Alchemy-Escape-Rooms-Inc/New-Cannons/Design/PCB/Imported-2026-10-09/CannonPCB.kicad_pcb

## KiCad design Design/PCB/Imported-2026-10-09/CannonPCB.kicad_pcb (2026-10-09)

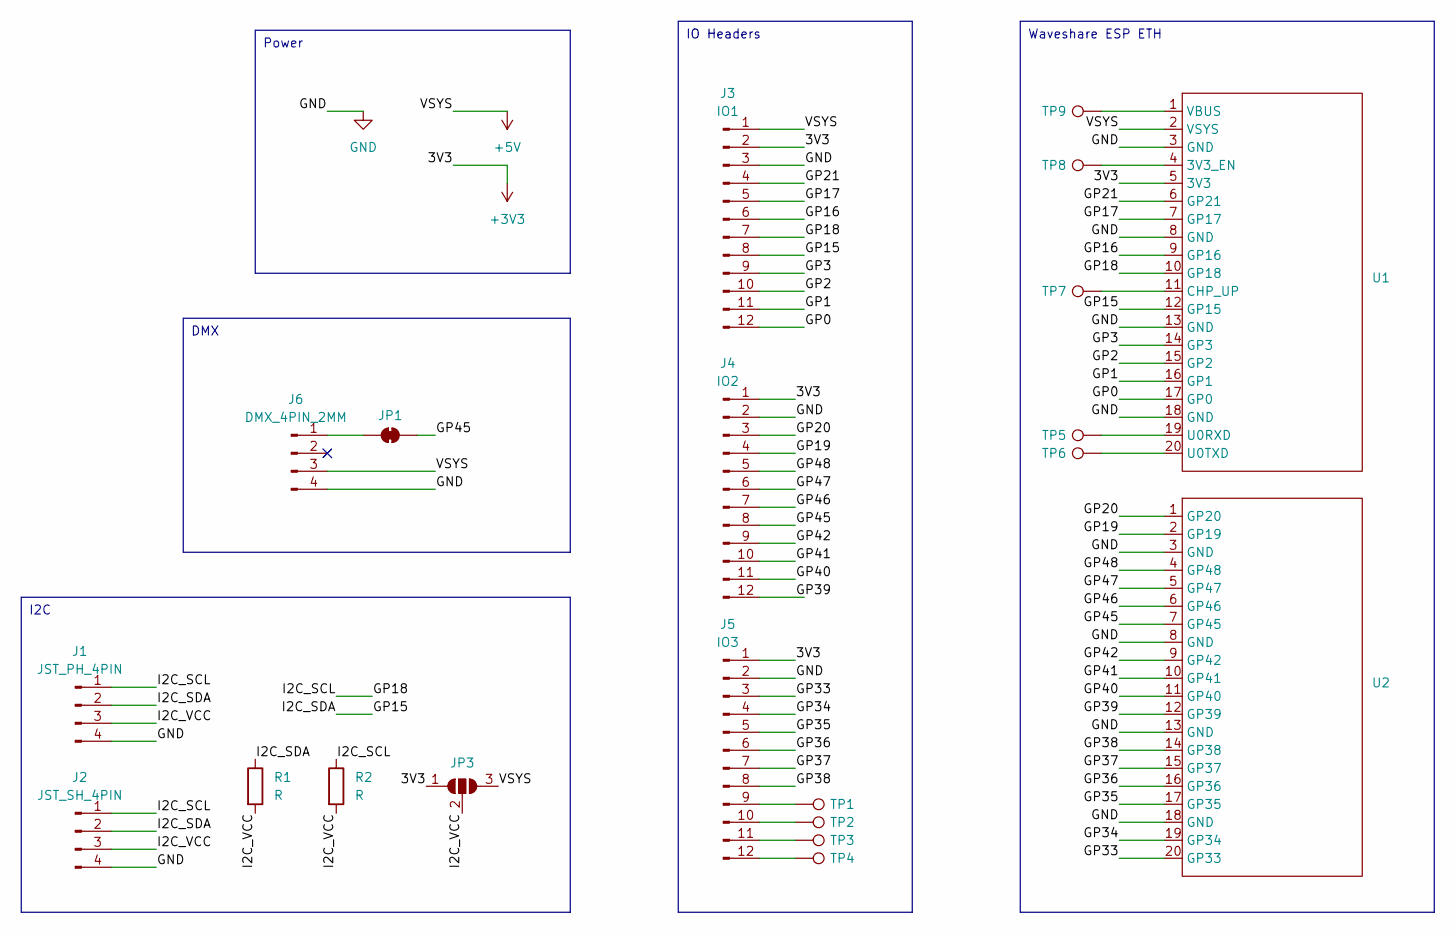
[picture p1: schematic CannonPCB.kicad_sch]

Parts:
J1: JST_PH_4PIN; JST_PH_B4B-PH-K_1x04_P2.00mm_Vertical
J2: JST_SH_4PIN; JST_SH_BM04B-SRSS-TB_1x04-1MP_P1.00mm_Vertical
J3: IO1; PinHeader_1x12_P2.54mm_Vertical
J4: IO2; PinHeader_1x12_P2.54mm_Vertical
J5: IO3; PinHeader_1x12_P2.54mm_Vertical
J6: DMX_4PIN_2MM; PinHeader_1x04_P2.00mm_Vertical
JP1: SolderJumper_2_Bridged; SolderJumper-2_P1.3mm_Bridged_RoundedPad1.0x1.5mm
JP3: SolderJumper_3_Open; SolderJumper-3_P1.3mm_Open_RoundedPad1.0x1.5mm
R1, R2: R; R_Axial_DIN0207_L6.3mm_D2.5mm_P10.16mm_Horizontal
TP1, TP2, TP3, TP4, TP5, TP6, TP7, TP8, TP9: TestPoint; TestPoint_THTPad_D2.0mm_Drill1.0mm
U1, U2: PinSocket_1x20_P2.54mm_Vertical

Connections:
+3V3: J3.2, J4.1, J5.1, JP3.1 (A), U1.5 (3V3)
+5V: J3.1, J6.3, JP3.3 (B), U1.2 (VSYS)
/GP0: J3.12, U1.17 (GP0)
/GP1: J3.11, U1.16 (GP1)
/GP2: J3.10, U1.15 (GP2)
/GP3: J3.9, U1.14 (GP3)
/GP15: J1.2, J2.2, J3.8, R1.1, U1.12 (GP15)
/GP16: J3.6, U1.9 (GP16)
/GP17: J3.5, U1.7 (GP17)
/GP18: J1.1, J2.1, J3.7, R2.1, U1.10 (GP18)
/GP19: J4.4, U2.2 (GP19)
/GP20: J4.3, U2.1 (GP20)
/GP21: J3.4, U1.6 (GP21)
/GP33: J5.3, U2.20 (GP33)
/GP34: J5.4, U2.19 (GP34)
/GP35: J5.5, U2.17 (GP35)
/GP36: J5.6, U2.16 (GP36)
/GP37: J5.7, U2.15 (GP37)
/GP38: J5.8, U2.14 (GP38)
/GP39: J4.12, U2.12 (GP39)
/GP40: J4.11, U2.11 (GP40)
/GP41: J4.10, U2.10 (GP41)
/GP42: J4.9, U2.9 (GP42)
/GP45: J4.8, JP1.2 (B), U2.7 (GP45)
/GP46: J4.7, U2.6 (GP46)
/GP47: J4.6, U2.5 (GP47)
/GP48: J4.5, U2.4 (GP48)
/I2C_VCC: J1.3, J2.3, JP3.2 (C), R1.2, R2.2
GND: J1.4, J2.4, J3.3, J4.2, J5.2, J6.4, U1.3 (GND), U1.8 (GND), U1.13 (GND), U1.18 (GND), U2.3 (GND), U2.8 (GND), U2.13 (GND), U2.18 (GND)
unnamed: J5.9, TP1.1
unnamed: J5.10, TP2.1
unnamed: J5.11, TP3.1
unnamed: J5.12, TP4.1
unnamed: J6.1, JP1.1 (A)
unnamed: TP8.1, U1.4 (3V3_EN)
unnamed: TP7.1, U1.11 (CHP_UP)
unnamed: TP5.1, U1.19 (U0RXD)
unnamed: TP6.1, U1.20 (U0TXD)
unnamed: TP9.1, U1.1 (VBUS)

Notes on the sheet:
Waveshare ESP ETH
I2C
DMX
IO Headers
Power

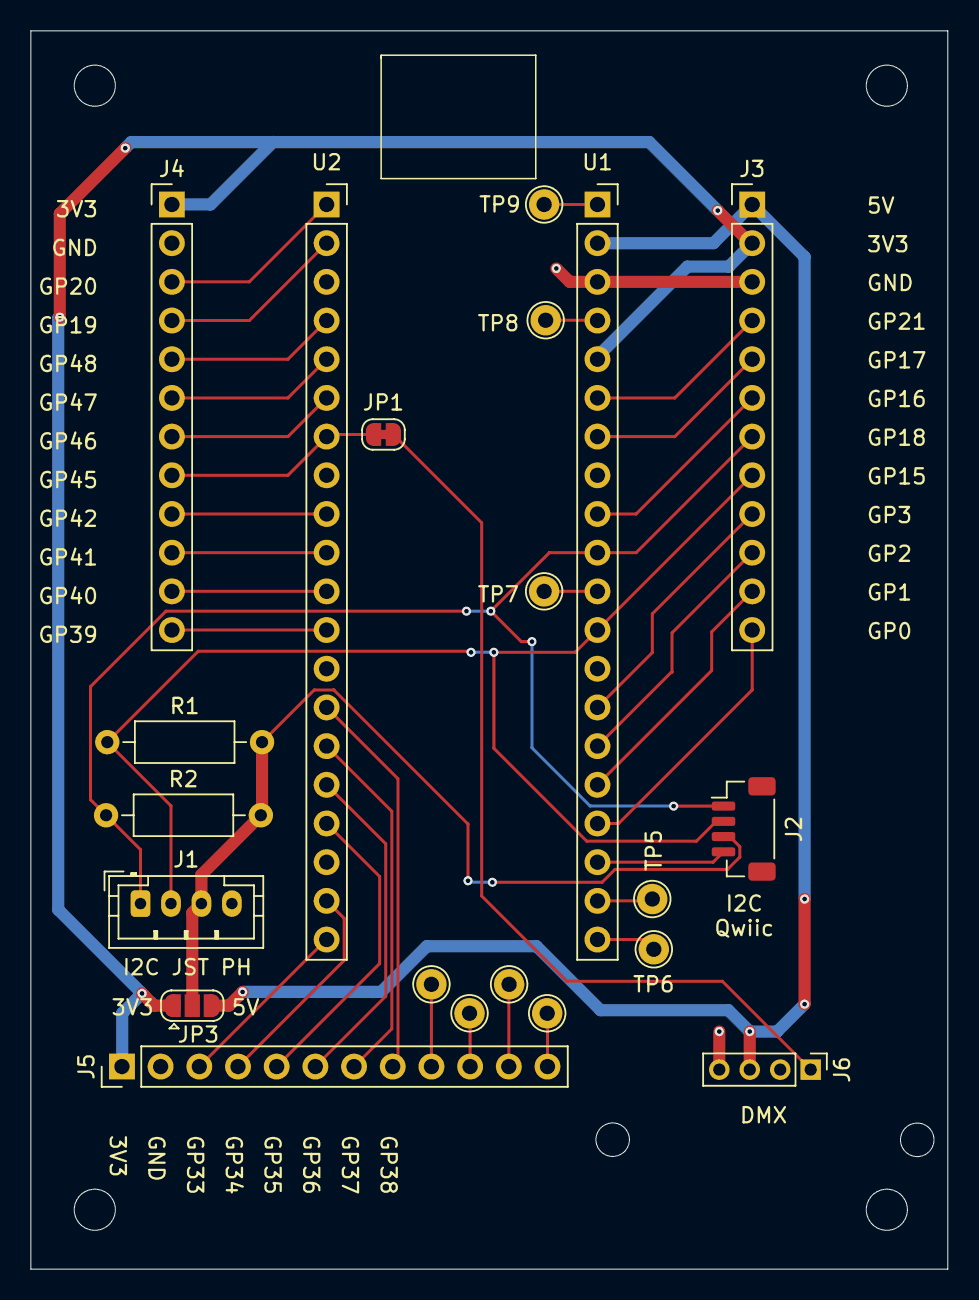
[picture p2: board CannonPCB.kicad_pcb from above]

Board: 2 copper layers, 60.2 x 81.3 mm, 21 parts (0 on the bottom side), 39 nets.
