Alchemy-Escape-Rooms-Inc/New-Cannons/(commit log)

2025-09-26 Update cannon telemetry and main implementation
    - Modified telemetry header configuration
    - Updated main.cpp implementation
    - Removed simple Arduino sketch in favor of PlatformIO structure
2025-09-27 Update main.cpp
    Main improvements:
    Dynamic address detection - The I2C scanner now saves the ALS31300 address when found
    Smart initialization - Uses the detected address instead of hardcoded 0x65
    Fallback support - Still tries the original address if scan doesn't find ALS31300
    Updated diagnostics - Shows which address is actually being used
    Reset command support - MQTT reset now uses the correct detected address
    [main.cpp]
2025-10-07 feat: Add configurable cannon ID and major improvements
    ✨ New Features:
    - Configurable cannon ID (change one constant in main.cpp)
    - Dynamic MQTT topic generation based on cannon ID
    - Auto-reconnection logic for MQTT
    - Watchdog timer for automatic restart on hang
    - Auto-status report after reset
    🐛 Bug Fixes:
    - Fixed memory leak in main loop
    - Added missing EthernetManager constructor
    - Fixed MQTT topic consistency (added slashes)
    🔧 Improvements:
    - Replaced magic numbers with config constants
    - Better angle wraparound handling
    - Improved ALS31300 address detection (0x60-0x6F)
    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
    [EthernetManager.cpp, als31300.cpp, main.cpp]
2025-11-12 fix: Reset loaded/fired flags after cannon fires to enable continuous firing
    After firing, the loaded and fired flags were not being reset, preventing
    the cannon from detecting new load/fire cycles without physically removing
    and reloading the target.
    Changes:
    - Add resetLoadedAndFired() method to CannonStateView to reset state flags
    - Call reset method immediately after "Fired" event is published
    - This allows continuous firing without requiring target removal/reload
    - Magnet angle updates continue normally throughout the process
    Fixes the issue where the cannon could only fire once per load cycle.
    [CannonStateView.h, main.cpp]
2025-11-12 fix: Fix loaded detection logic and add angle/distance logging
    Fixed critical bug where cannon was always detecting as "loaded" when
    the distance sensor was valid, regardless of actual distance reading.
    - Fix loaded detection: Now uses threshold-based detection (≤50mm)
    instead of always returning true when sensor is valid
    - Change threshold from 120mm to 50mm (background reads 76-78mm)
    - Add angle and distance to periodic status reports for debugging
    - Add distance value to "Loaded" event log messages
    The cannon will now only detect as "loaded" when an object is within
    50mm, preventing false positives from background readings at 76-78mm.
    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
    [ControllerState.h, main.cpp]
2025-11-12 Fix snprintf syntax error
    [main.cpp]
2025-11-12 Add auto-upload script for pulling latest code and uploading to ESP32
2025-11-13 Remove angle jump rejection that was blocking legitimate angle updates
    The angle jump rejection logic (MAX_ANGLE_JUMP_DEG threshold) was preventing
    the filtered angle from converging to the raw angle when the difference exceeded
    10 degrees. This caused the system to get stuck rejecting valid angle readings.
    Now the filter uses pure exponential moving average without rejection, allowing
    it to smoothly converge to the correct angle even after large changes while still
    providing noise smoothing.
    [main.cpp]
2025-11-13 Remove all angle filtering - use raw angle values for MQTT
    Removed angle filtering at both levels:
    1. ALS31300 sensor: Removed Cartesian-space filtering in getAngle()
    2. main.cpp: Removed exponential moving average filtering
    Now publishes raw angle values directly to MQTT without any filtering
    or jump rejection. X/Y magnetometer readings still have basic noise
    filtering, but angle calculation is direct.
    [als31300.cpp, main.cpp]
2025-11-14 Final cannon firmware with MQTT telemetry and raw angle tracking
    Key features:
    - Raw angle values without filtering for accurate cannon positioning
    - MQTT telemetry for angle, loaded, and fired events
    - Distance filtering with configurable alpha
    - Watchdog timer for system stability
    - I2C bus scanning and recovery
    - Per-cannon MQTT topics (Cannon1, Cannon2, etc.)
    - Automatic state reset after firing
    - Comprehensive diagnostics and status reporting
    Configuration:
    - CANNON_ID = 2 (change for each cannon)
    - Uses VL6180X for distance sensing
    - Uses ALS31300 for angle sensing
    [main.cpp]
2025-11-17 Add Fort Lauderdale real estate search and analysis tool
    This comprehensive tool searches multiple sources for Fort Lauderdale properties,
    analyzes them for investment potential and personal residence suitability, and
    sends daily email reports with findings.
    Features:
    - Multi-source property search (MLS, auctions, public records)
    - Real Broward County foreclosure auction integration
    - Smart property analysis with scoring (0-100)
    - Investment metrics: cap rate, cash flow, 1% rule
    - Personal residence criteria: location, age, size
    - Email reports with HTML formatting
    - Daily automated searches via cron or scheduler
    - Property tracking database to identify new listings
    Files added:
    - fort_lau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
2026-01-15 feat: Add Watchtower Protocol compliance v3.0.0
    - PING/PONG, STATUS, RESET, PUZZLE_RESET commands
    - 5-minute heartbeat status reports
    - Topic buffer copy fix in MQTT callback
    - VERSION define for system checker
    - Gravity Games integration (triggered/clear payloads)
    - Cannon ID 1 configured
    [main.cpp]
2026-01-15 feat: Integrate ALS31300 angle sensor driver
    - Added ALS31300 driver include and I2C callback functions
    - Updated setupSensors() to properly initialize ALS31300
    - Updated readAngle() to read actual sensor data with filtering
    - Bumped version to 3.1.0
2026-01-25 feat: Add Watchtower Protocol v3.2.0
    - Add VERSION define for Watchtower compliance
    - Implement /command topic for PING, STATUS, RESET, PUZZLE_RESET commands
    - Add 5-minute heartbeat status reporting via /status topic
    - Add logging via /log topic
    - Update ALS31300 fallback address to 0x01
    - Comment out COM port settings for portability
    [main.cpp]
2026-02-14 Add MANIFEST.h and bridge MqttConfig.h/main.cpp to manifest system
    Adds the self-documenting firmware manifest (MANIFEST.h) as the single
    source of truth for all device constants, pin assignments, network config,
    and operational documentation with @TAG markers for the Grimoire parser.
    MqttConfig.h now bridges to manifest:: values via cfg:: namespace.
    main.cpp config namespace and VERSION define now reference manifest::.
    Zero changes to function calls or logic.
2026-05-05 feat: Amplify physical pivot 3x and raise presence threshold to 150mm
    Scale physical cannon angle deviations from rest by ANGLE_AMPLIFICATION
    (default 3.0) so the Unreal cannon swings farther than the prop. Output
    wraps via shortest-delta around ANGLE_REST_DEG.
    Raise VL6180X presence threshold from 50mm to 150mm to reliably detect
    the cannonball as it rolls past the sensor.
    [ControllerState.h, MANIFEST.h, main.cpp]
2026-06-06 fix: Reverse aim direction (-3x gain) and set CANNON_ID to 1
    Physical left-pivot was producing right-aim in Unreal; negating the
    angle amplification flips the output direction. Also retargets this
    firmware build to Cannon 1.
    [MANIFEST.h]
2026-09-19 v3.3.0: presence hysteresis, RESET boot-grace, rope-pull diagnostics over MQTT
    - ControllerState: 15 mm hysteresis on ball presence. A ball at the 150 mm
    threshold flapped loaded/unloaded every loop (2026-07-09: 102 Loaded events
    in ~1 s, game crashed 15 s later).
    - main: ignore RESET within 8 s of an MQTT (re)connect - PubSubClient hides
    the retain bit, and a retained RESET replayed on subscribe reboot-looped
    Cannon 2.
    - main: rope-pull button press/release mirrored to /log; STATUS reply now
    carries live Angle / Dist / Btn so the fire switch can be proven without a
    serial cable (Cannon 1 has never published Fired on the wire, 09-18 play:
    5 loads, 0 fires).
    - main: esp_task_wdt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
    [ControllerState.h, MANIFEST.h, main.cpp]
2026-10-09 Add prop design files found outside the repo (cleanup 2026-10-09)
    Files the owner chose to keep from Downloads / OneDrive / Desktop; they were
    in no repo. Placed in Design/PCB/Imported-2026-10-09.
2026-11-10 v3.4.0: auto-detect VL6180X or VL53L0X ToF; one Fired per rope pull (Merlin A44 patch); wrap-aware angle hysteresis (>=4) to stop flicker flood; ArduinoOTA; per-cannon pio envs (cannon1/cannon2)
